greenscreenflicker/open-led-stip-dimmer/README.md

# open-led-stip-dimmer
This is an open led stipe dimmer for MakerCon 2017 (16.2-18.2) in Heidelberg, Germany.
The project is used as sample project to explain the basics of PCB layout.

# Tutorial
The script (in German) can be found in the folder "doc".
