greenscreenflicker/open-led-stip-dimmer/pcb/gerber/noteforproduction.txt

For stencil production use *-F.Paste.
For PCB production all other files.
