greenscreenflicker/open-led-stip-dimmer/pcb/assembly/ledstipdimmer-F.SilkS.pdf

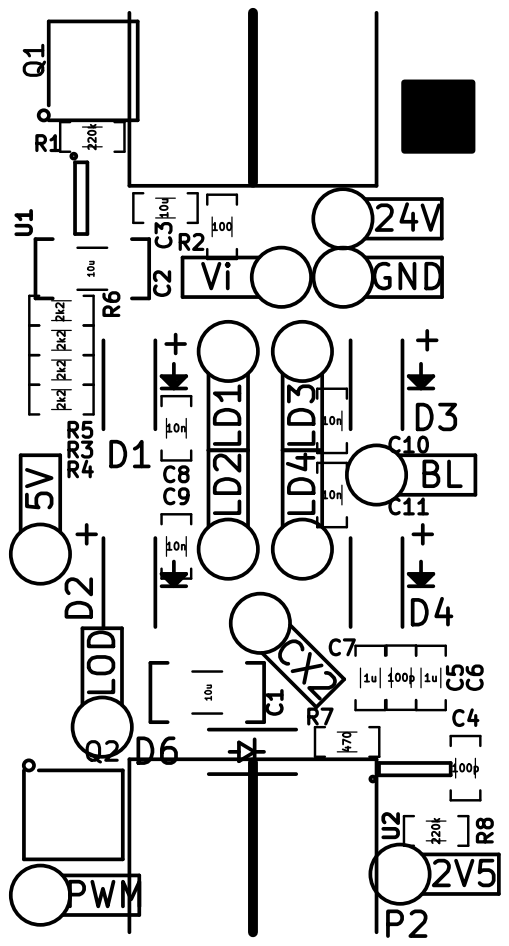
[picture p1: page 1]
