greenscreenflicker/open-led-stip-dimmer/pcb/ledstipdimmer.kicad_pcb

## KiCad design pcb/ledstipdimmer.kicad_pcb (2017-01-04)

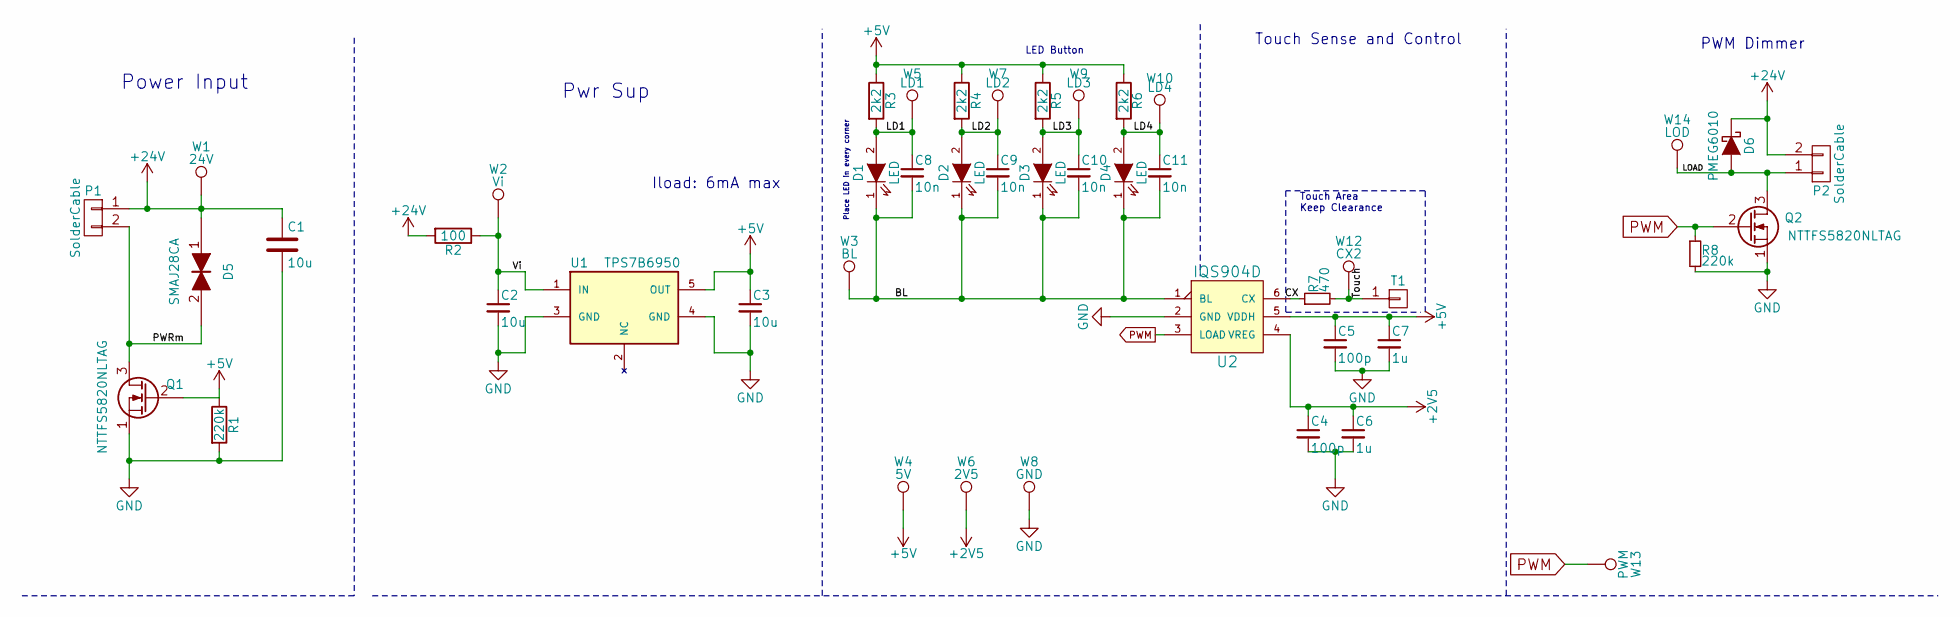
[picture p2: schematic ledstipdimmer.sch, Open LED Stip Dimmer]

Parts:
C1, C2: 10u; SMD-C-1206; Voltage 50V
C3: 10u; SMD-C-0603; Voltage 10V
C4, C5: 100p; SMD-C-0603; Voltage 10V
C6, C7: 1u; SMD-C-0603; Voltage 10V
C8, C9, C10, C11: 10n; SMD-C-0603; Voltage 50V
D1, D2, D3, D4: LED; LED_1206_revmnt
D5: SMAJ28CA; SMA_Bipolar
D6: PMEG6010; SOD-123
P1, P2: SolderCable; solder_cable_2
Q1, Q2: NTTFS5820NLTAG; WDFN8_3.3x3.3
R1, R8: 220k; SMD-R-0603
R2: 100; SMD-R-0603
R3, R4, R5, R6: 2k2; SMD-R-0603
R7: 470; SMD-R-0603
T1: TOUCH; touch15x15
U1: TPS7B6950; SOT-23-5; Mouser# 595-TPS7B6950DBVR
U2: IQS904D; SOT-23-6; Mouser# IQS904D-00000TSR
W1: 24V; RECP_709150001050006
W2: Vi; RECP_709150001050006
W3: BL; RECP_709150001050006
W4: 5V; RECP_709150001050006
W5: LD1; RECP_709150001050006
W6: 2V5; RECP_709150001050006
W7: LD2; RECP_709150001050006
W8: GND; RECP_709150001050006
W9: LD3; RECP_709150001050006
W10: LD4; RECP_709150001050006
W12: CX2; RECP_709150001050006
W13: PWM; RECP_709150001050006
W14: LOD; RECP_709150001050006

Connections:
+2V5: C4.1, C6.1, U2.4 (VREG), W6.1
+5V: C3.1, C5.1, C7.1, Q1.2 (G), R1.1, R3.1, R4.1, R5.1, R6.1, U1.5 (OUT), U2.5 (VDDH), W4.1
+24V: C1.1, D5.1, D6.1 (K), P1.1, P2.2, R2.2, W1.1
/BL: C8.2, C9.2, C10.2, C11.2, D1.1 (K), D2.1 (K), D3.1 (K), D4.1 (K), U2.1 (BL), W3.1
/CX: R7.1, U2.6 (CX)
/LD1: C8.1, D1.2 (A), R3.2, W5.1
/LD2: C9.1, D2.2 (A), R4.2, W7.1
/LD3: C10.1, D3.2 (A), R5.2, W9.1
/LD4: C11.1, D4.2 (A), R6.2, W10.1
/LOAD: D6.2 (A), P2.1, Q2.3 (D), W14.1
/PWRm: D5.2, P1.2, Q1.3 (D)
/Touch: R7.2, T1.1, W12.1
/Vi: C2.1, R2.1, U1.1 (IN), W2.1
GND: C1.2, C2.2, C3.2, C4.2, C5.2, C6.2, C7.2, Q1.1 (S), Q2.1 (S), R1.2, R8.2, U1.3 (GND), U1.4 (GND), U2.2 (GND), W8.1
PWM: Q2.2 (G), R8.1, U2.3 (LOAD), W13.1

Notes on the sheet:
Touch Sense and Control
Power Input
Pwr Sup
Iload: 6mA max
LED Button
PWM Dimmer
Place LED in every corner
Touch Area Keep Clearance

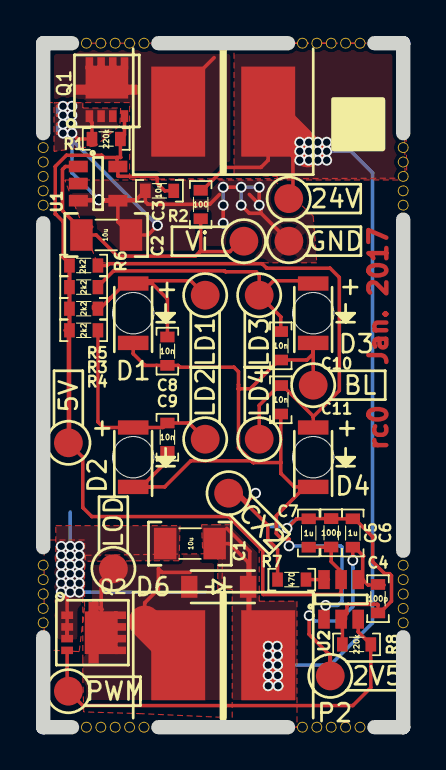
[picture p3: board ledstipdimmer.kicad_pcb from above]

Board: 2 copper layers, 20.0 x 38.0 mm, 43 parts (0 on the bottom side), 15 nets.
