greenscreenflicker/open-led-stip-dimmer/(commit log)

2016-12-30 Inital schematic design.
    [ledstipdimmer.kicad_pcb, ledstipdimmer.sch]
2016-12-31 PCB design waiting for review.
    [ledstipdimmer.kicad_pcb, ledstipdimmer.sch]
2017-01-01 Resolved DRC conflicts. Adjustments left.
    [ledstipdimmer.kicad_pcb, ledstipdimmer.sch]
2017-01-04 Produced panel and corresponding gerber files.
    [ledstipdimmer.kicad_pcb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]
2017-01-05 Updated files.
    [ledstipdimmer_panel-B.Cu.gbr, ledstipdimmer_panel-B.Mask.gbr, ledstipdimmer_panel-B.SilkS.gbr, ledstipdimmer_panel-Edge.Cuts.gbr, ledstipdimmer_panel-F.Cu.gbr, ledstipdimmer_panel-F.Mask.gbr, ledstipdimmer_panel-F.Paste.gbr, ledstipdimmer_panel-F.SilkS.gbr]
2017-01-11 Production adjustments for Aetzwerk (Solder Resist with reduces for enhanced quality).
    [ledstipdimmer_panel-B.Cu.gbr, ledstipdimmer_panel-B.Mask.gbr, ledstipdimmer_panel-B.SilkS.gbr, ledstipdimmer_panel-Edge.Cuts.gbr, ledstipdimmer_panel-F.Cu.gbr, ledstipdimmer_panel-F.Mask.gbr, ledstipdimmer_panel-F.Paste.gbr, ledstipdimmer_panel-F.SilkS.gbr]
2017-02-08 Uploaded script.
    [ledstipdimmer.sch]
